Valleeh/taptempo-box/nano-perfboard/mech/out/view_rear.png

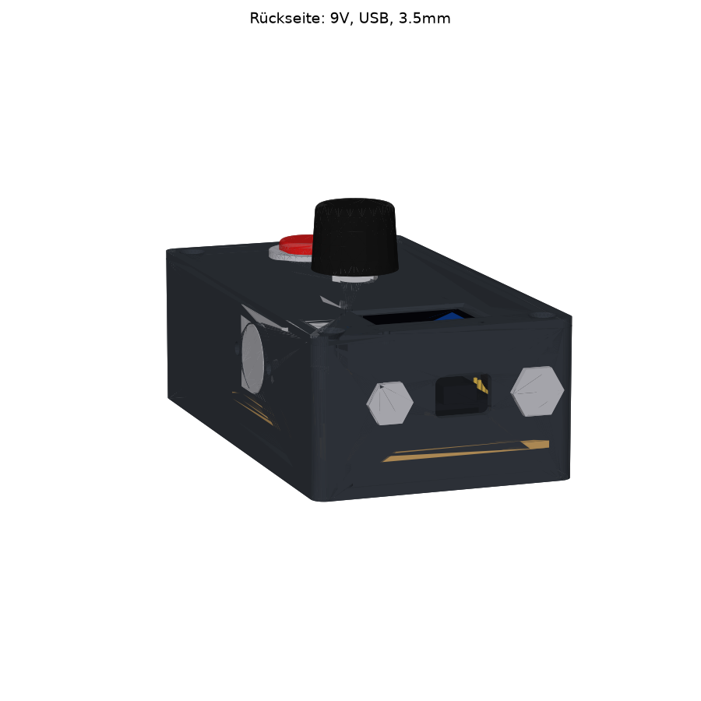
nano-perfboard/mech/out/view_rear.png
