Valleeh/taptempo-box/nano-perfboard/mech/out/view_section.png

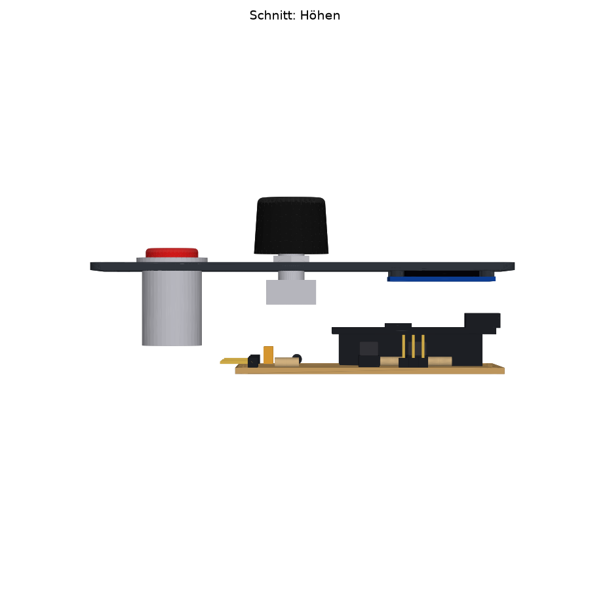
nano-perfboard/mech/out/view_section.png
