Valleeh/taptempo-box/nano-perfboard/mech/out/view_side.png

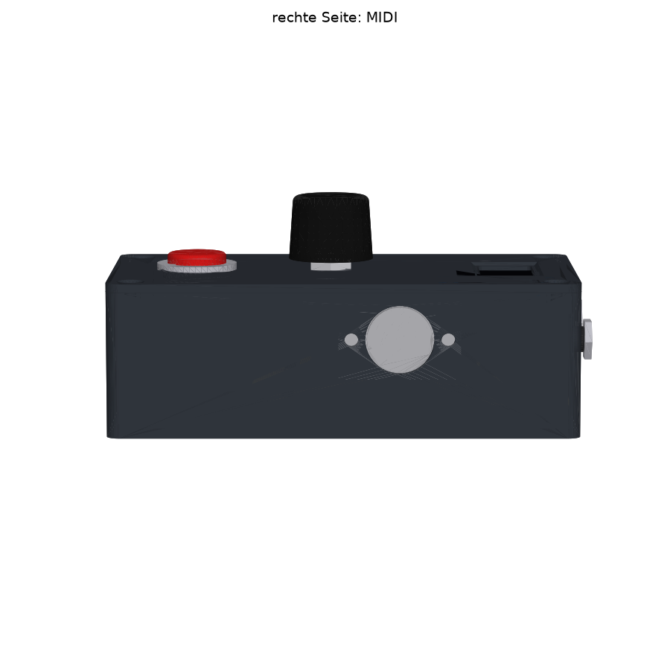
nano-perfboard/mech/out/view_side.png
