Valleeh/taptempo-box/nano-perfboard/mech/out/view_top.png

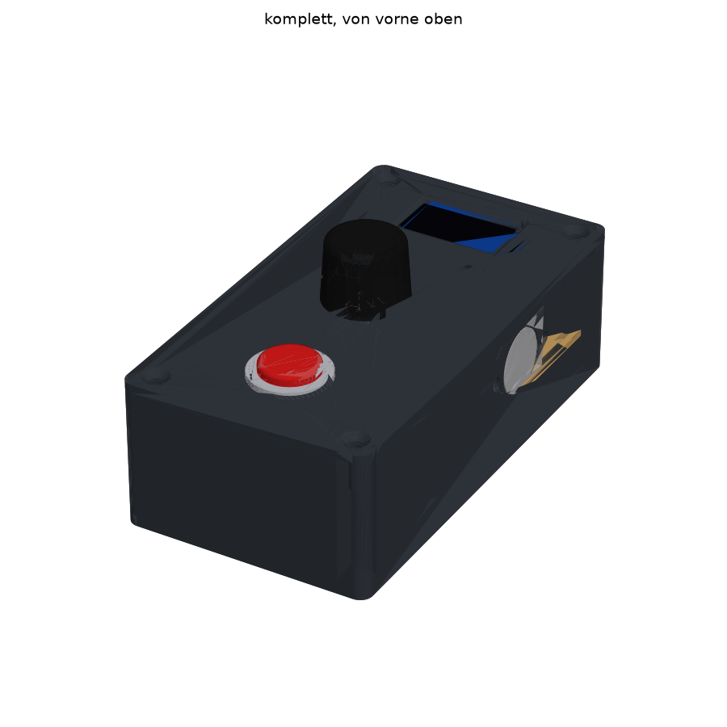
nano-perfboard/mech/out/view_top.png
