Valleeh/taptempo-box/smd-pcb/fab/vorschau_oben.png

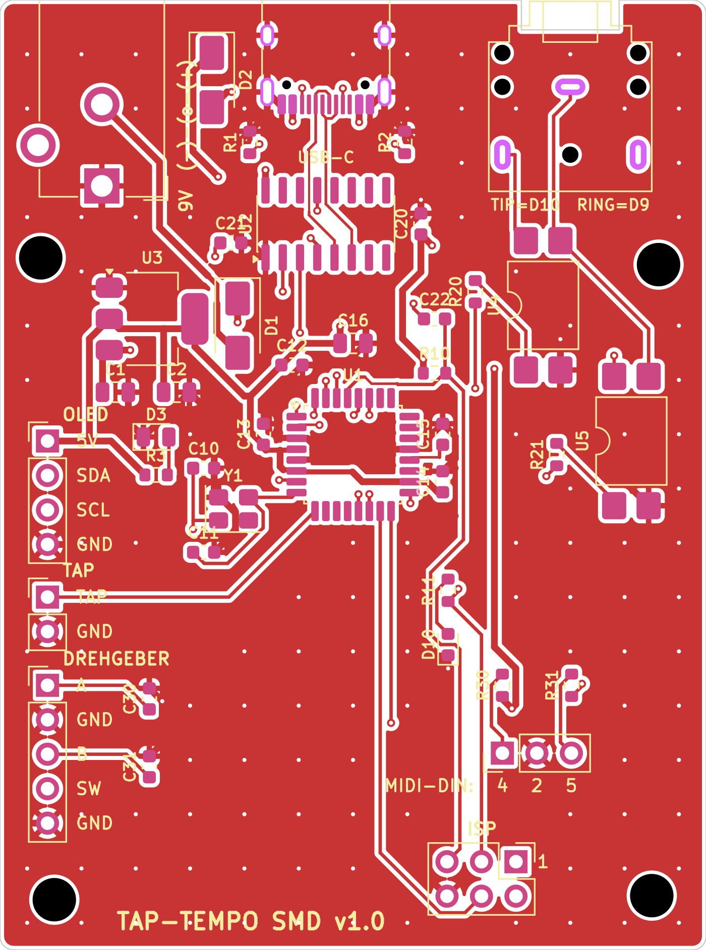
smd-pcb/fab/vorschau_oben.png
