Valleeh/taptempo-box/smd-pcb/fab/vorschau_unten.png

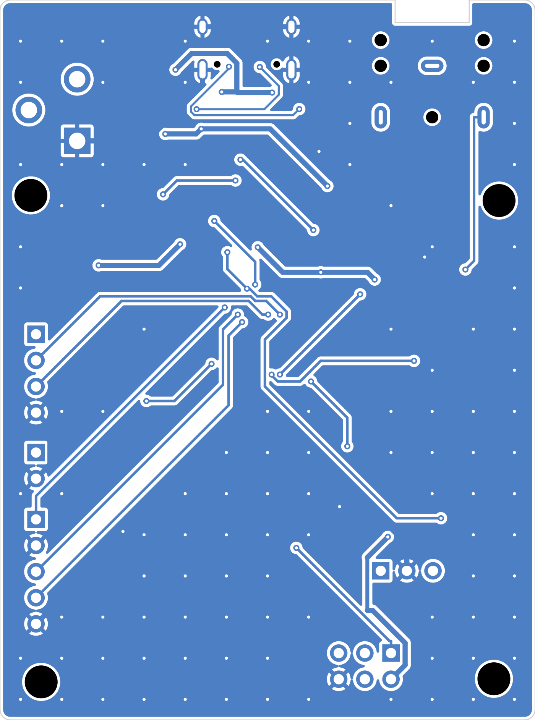
smd-pcb/fab/vorschau_unten.png
