Valleeh/taptempo-box/smd-pcb/mech/out/view_rear.png

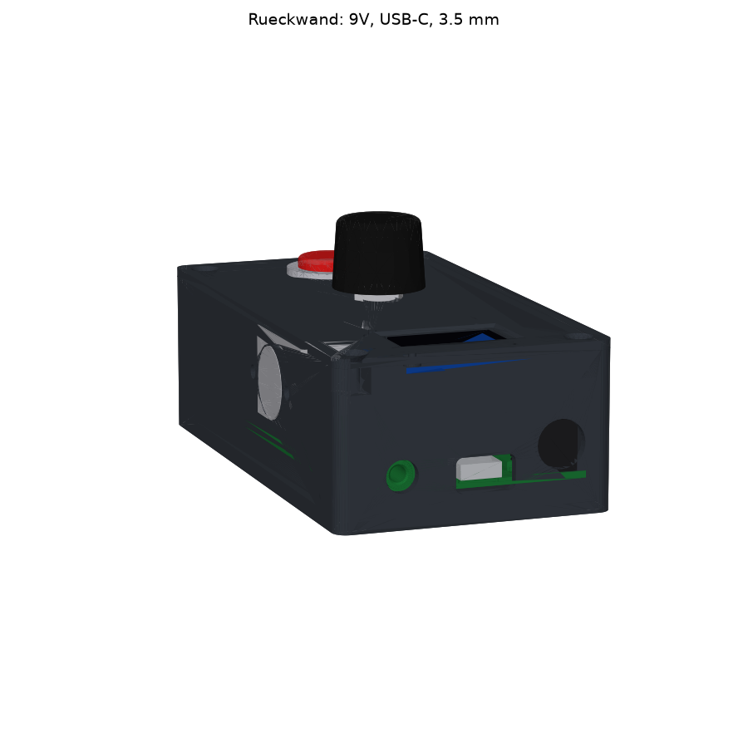
smd-pcb/mech/out/view_rear.png
