Valleeh/taptempo-box/smd-pcb/mech/out/view_section.png

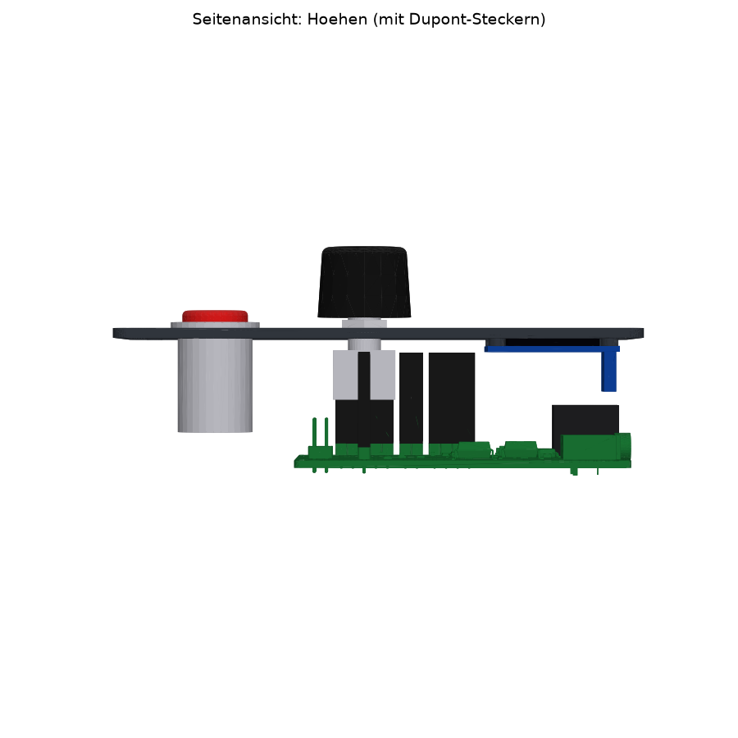
smd-pcb/mech/out/view_section.png
