Valleeh/taptempo-box/smd-pcb/fab/bom_jlcpcb.csv

Comment | Designator | Footprint | LCSC Part #
12pF | C10,C11 | C_0603_1608Metric | C38523
100nF | C12,C13,C14,C15,C20,C21,C22,C30,C31 | C_0603_1608Metric | C14663
10uF | C1,C16 | C_0805_2012Metric | C15850
22uF | C2 | C_0805_2012Metric | C45783
LED_R | D10 | LED_0603_1608Metric | C2286
SS14 | D1,D2 | D_SMA | C2480
LED_G | D3 | LED_0805_2012Metric | C2297
USB-C | J1 | USB_C_Receptacle_HRO_TYPE-C-31-M-12 | C165948
5.1k | R1,R2 | R_0603_1608Metric | C23186
10k | R10 | R_0603_1608Metric | C25804
1k | R3,R11 | R_0603_1608Metric | C21190
220 | R20,R21,R30,R31 | R_0603_1608Metric | C22962
ATmega328P-AU | U1 | TQFP-32_7x7mm_P0.8mm | C14877
CH340C | U2 | SOIC-16_3.9x9.9mm_P1.27mm | C84681
AMS1117-5.0 | U3 | SOT-223-3_TabPin2 | C6187
PC817C | U4,U5 | SMDIP-4_W9.53mm | C3025164
16MHz | Y1 | Crystal_SMD_3225-4Pin_3.2x2.5mm | C13738
