Valleeh/taptempo-box/smd-pcb/fab/tht_selbst_loeten.csv

Bauteil | Designator | Footprint | LCSC Part # | Menge pro Platine
9V DC (PJ-102AH), Minus innen | J2 | BarrelJack_CUI_PJ-102AH_Horizontal | C3096093 | 1
3.5mm TRS (SJ1-3523N) | J3 | Jack_3.5mm_CUI_SJ1-3523N_Horizontal | C20182914 | 1
MIDI DIN (4, 2=GND, 5) | J7 | PinHeader_1x03_P2.54mm_Vertical | C2937625 | 1
OLED (5V SDA SCL GND) | J4 | PinHeader_1x04_P2.54mm_Vertical | C2691448 | 1
Drehgeber (A GND B SW GND) | J5 | PinHeader_1x05_P2.54mm_Vertical | C492404 | 1
TAP (TAP GND) | J6 | PinHeader_1x02_P2.54mm_Vertical | C492401 | 1
ISP (Bootloader) | J8 | PinHeader_2x03_P2.54mm_Vertical | C65114 | 1
