Valleeh/taptempo-box/nano-perfboard/mech/out/assembly.step

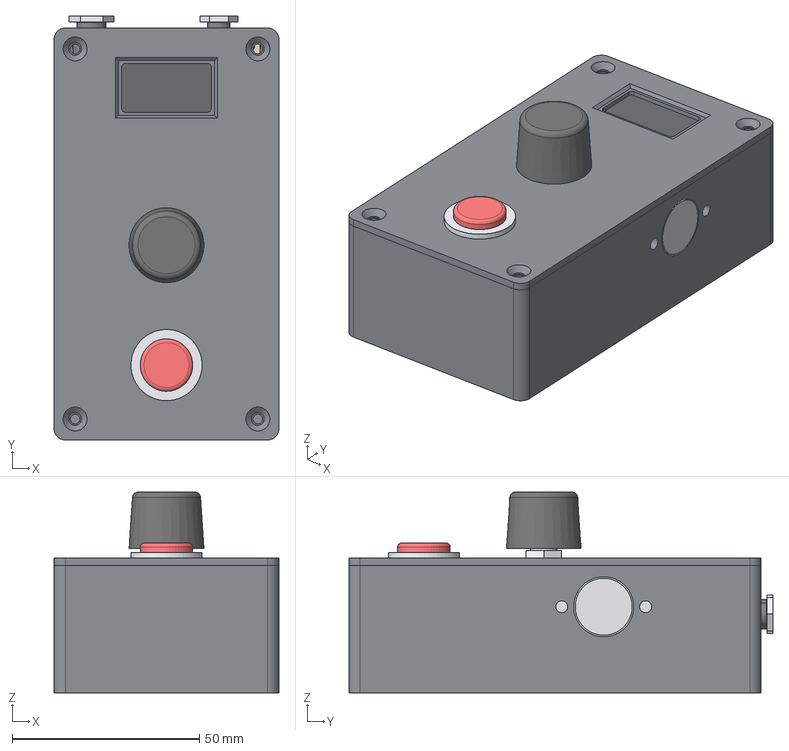
[picture p12: CAD file, 2026-10-27]
nano-perfboard/mech/out/assembly.step
60.0 x 113.2 x 53.6 mm
tray
lid
perfboard
sockets
nano
resistors
ics
headers
pins
diode
caps
encoder
encoder_nut
knob
tap_body
tap_cap
oled_pcb
oled_glass
midi_din
dc_jack
dc_nut
trs_jack
trs_nut
