Valleeh/taptempo-box/smd-pcb/mech/out/assembly.step

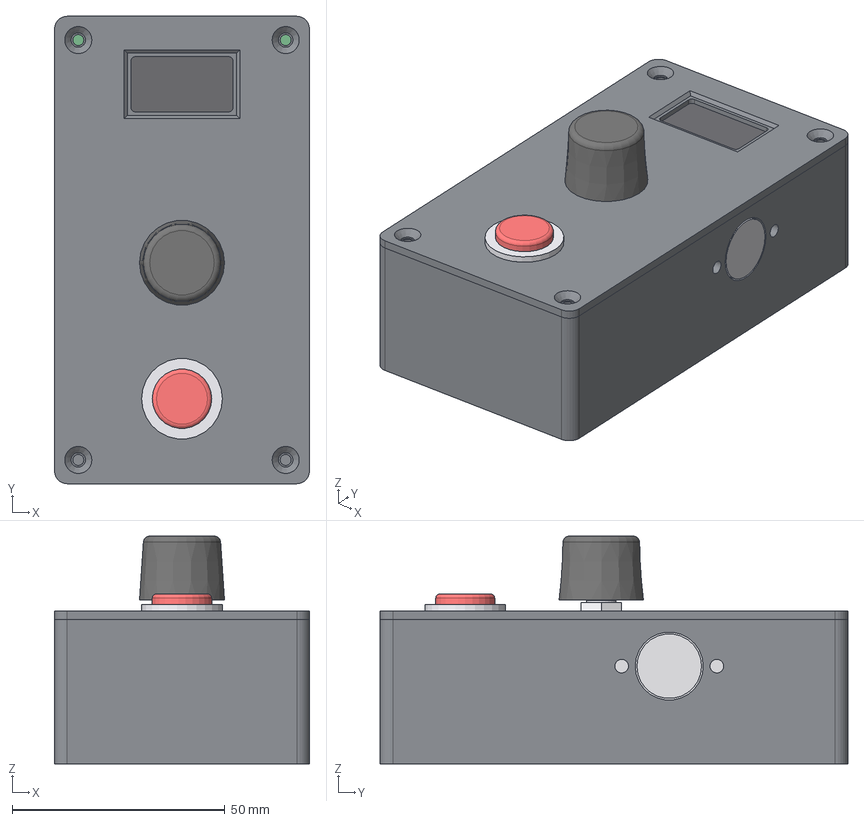
[picture p13: CAD file, 2026-10-27]
smd-pcb/mech/out/assembly.step
60.0 x 110.0 x 53.6 mm
tray
lid
pcb
usb_c
dc_jack
dupont
encoder
encoder_nut
knob
tap_body
tap_cap
oled_pcb
oled_glass
midi_din
