Valleeh/taptempo-box/nano-perfboard/mech/out/tray.step

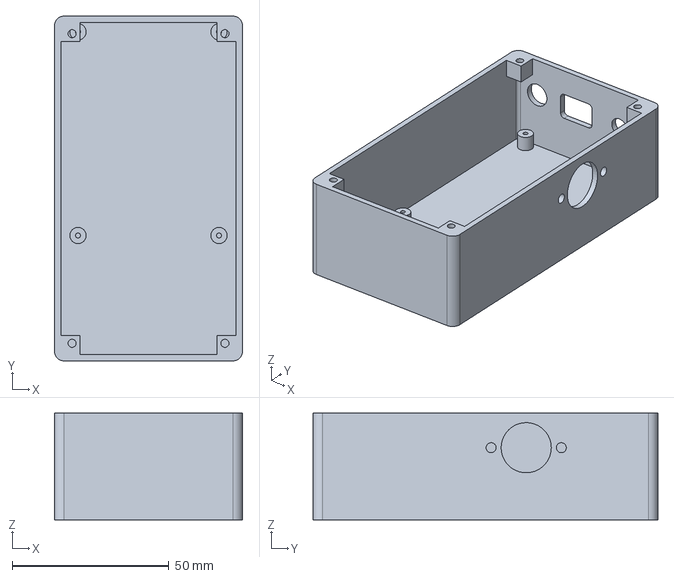
[picture p14: CAD file, 2026-10-27]
nano-perfboard/mech/out/tray.step
60.0 x 110.0 x 34.0 mm
