Valleeh/taptempo-box/nano-perfboard/mech/pcb.step

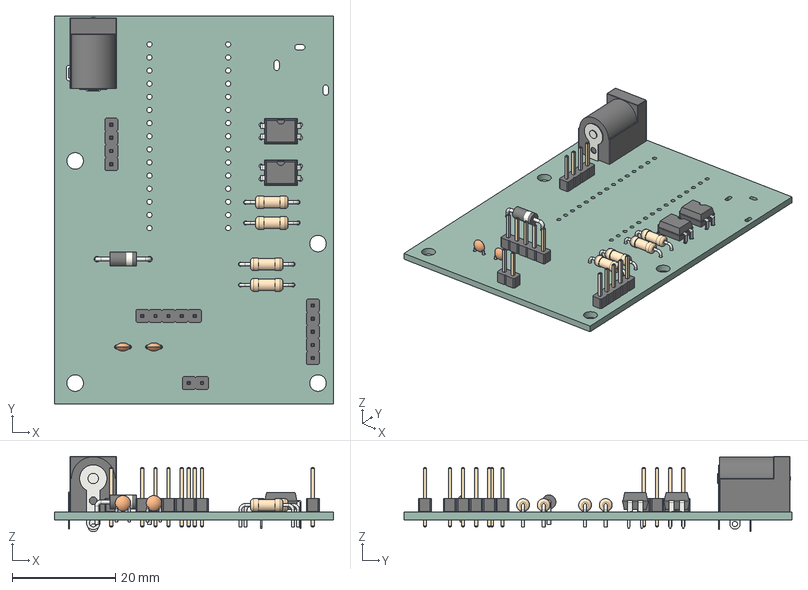
[picture p15: CAD file, 2026-10-27]
nano-perfboard/mech/pcb.step
54.0 x 75.0 x 14.6 mm
DIP-4_W7.62mm x 2
C_Disc_D30mm_W16mm_P250mm x 2
BarrelJack_Horizontal
PinHeader_1x02_P254mm_Vertical
PinHeader_1x05_P254mm_Vertical x 2
R_Axial_DIN0207_L63mm_D25mm_P1016mm_Horizontal x 4
D_DO-41_SOD81_P10.16mm_Horizontal
PinHeader_1x04_P254mm_Vertical
taptempo_PCB
