Valleeh/taptempo-box/nano-perfboard/mech/out/lid.step

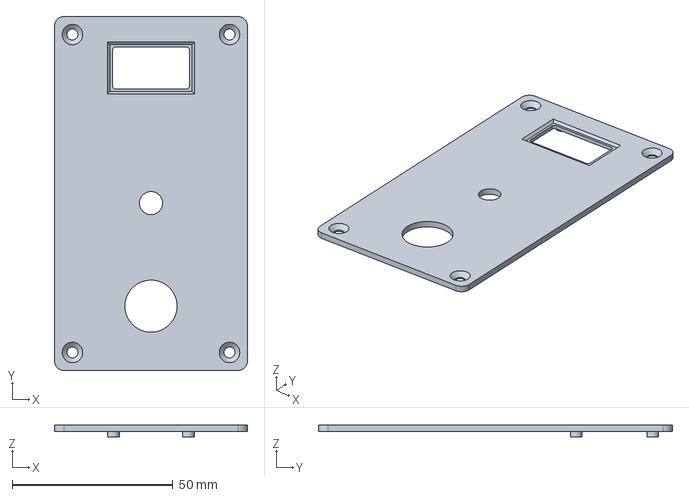
[picture p16: CAD file, 2026-10-27]
nano-perfboard/mech/out/lid.step
60.0 x 110.0 x 3.60 mm
