Valleeh/taptempo-box/smd-pcb/mech/out/pcb.step

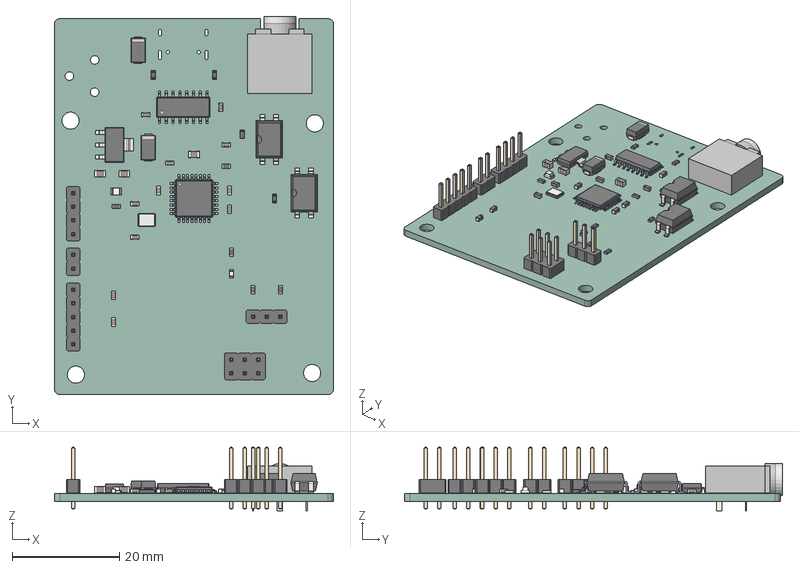
[picture p17: CAD file, 2026-10-27]
smd-pcb/mech/out/pcb.step
52.0 x 70.4 x 11.8 mm
R_0603_1608Metric x 9
C_0603_1608Metric x 11
SMDIP_4_W953mm x 2
LED_0603_1608Metric
Crystal_SMD_3225-4Pin_3.2x2.5mm
D_SMA x 2
C_0805_2012Metric x 3
TQFP-32_7x7mm_P0.8mm
SOIC-16_3.9x9.9mm_P1.27mm
LED_0805_2012Metric
PinHeader_1x02_P254mm_Vertical
PinHeader_1x05_P254mm_Vertical
PinHeader_1x03_P254mm_Vertical
SOT-223
PinHeader_1x04_P254mm_Vertical
Jack_3.5mm_CUI_SJ1-3523N_Horizontal
PinHeader_2x03_P254mm_Vertical
taptempo-smd_PCB
