Valleeh/taptempo-box/(list of files, cad)

Other CAD files:
smd-pcb/mech/out/tray.step
smd-pcb/mech/out/lid.step
nano-perfboard/mech/out/lid.stl
nano-perfboard/mech/out/tray.stl
smd-pcb/mech/out/lid.stl
smd-pcb/mech/out/tray.stl
