Valleeh/taptempo-box/nano-perfboard/share/taptempo-bauanleitung.html

# Tap-Tempo-Box löten

Schritt für Schritt auf einer Lochrasterplatine, ohne Vorkenntnisse. Alles, was man falsch herum einsetzen kann, ist markiert. Hake beim Löten ab, was erledigt ist; die Haken bleiben in diesem Browser gespeichert.

Zeit: ca. 4–6 StundenPlatine 5 × 7 cm, 18 × 24 Löcher26 Brücken, 10 Drähte0 erledigt

## Einkaufsliste

Anzahl | Teil | Hinweis
1 | Lochrasterplatine 5 × 7 cm (Lötpunkte, 2,54 mm) | doppelseitig verzinnt ist leichter zu löten
1 | Arduino Nano (Klon reicht) | mit Mini-USB oder USB-C, beides passt
2 | Buchsenleiste 15-polig, 2,54 mm | Sockel für den Nano
2 | IC-Sockel 4-polig (DIP-4) | oder einen 8-poligen durchsägen
2 | Optokoppler PC817 | DIP-Gehäuse
4 | Widerstand 220 Ω, ¼ W | Farbringe Rot-Rot-Braun
2 | Kondensator 100 nF (Keramik, „104“) | Rastermaß 2,5 mm
1 | Schottky-Diode 1N5817 | Verpolschutz
1 | Stiftleiste gerade, 1 × 40 | für Display und Klinke
1 | Stiftleiste gewinkelt 90°, 1 × 40 | für die vordere Reihe
1 Pack | Dupont-Kabel Buchse–Buchse, 20 cm | werden halbiert, kein Crimpen nötig
1 | Drehgeber EC11 mit Drucktaster + Knopf | 5 Beine: 3 vorne, 2 hinten
1 | Drucktaster 16 mm, nicht rastend | max. 22 mm tief
1 | OLED 0,96″ I²C (SSD1306), 4 Pins | 27 × 28 mm
1 | MIDI-Einbaubuchse DIN 5-polig 180° | mit 2 Schraublöchern
1 | Klinken-Einbaubuchse 3,5 mm Stereo | Gewinde M6
1 | Hohlstecker-Einbaubuchse 5,5/2,1 mm | passend zu deinem Netzteil
je 4 | Schrauben M2 × 6 und M3 × 8 (Senkkopf) | Platine bzw. Deckel
| Schaltdraht (isoliert) in mehreren Farben, verzinnter Draht 0,5 mm, Schrumpfschlauch

### Werkzeug

Lötkolben mit Temperaturregelung, Lötzinn 0,8 mm mit Flussmittel, Seitenschneider, Abisolierzange, Multimeter mit Piepser, „dritte Hand“ oder Knete zum Festhalten, Filzstift.

## Fünf Regeln fürs Löten

1. Lötkolben auf ca. 330 °C. Die Spitze immer leicht verzinnt halten, am nassen Schwamm oder Messingwolle abwischen.
2. Erst Pad und Bein 1–2 Sekunden gleichzeitig erhitzen, dann das Zinn an die Stelle halten (nicht an die Spitze).
3. Eine gute Lötstelle glänzt und sieht aus wie ein kleiner Vulkan. Eine Kugel oder graue Krümel: noch mal erhitzen.
4. Nach jedem Bauteil die Beine kurz abschneiden. Nicht länger als 3–4 Sekunden auf einer Stelle bleiben.
5. Nie löten, solange USB oder Netzteil angeschlossen ist. Gut lüften.

## Der Lochplan

Die Löcher sind wie auf einem Steckbrett benannt: Spalten A–R von links nach rechts, Reihen 1–24 von hinten nach vorne. K12 heißt Spalte K, Reihe 12.

Wichtig: Von unten ist alles seitenverkehrt. Schreib mit Filzstift auf beide Seiten der Platine „A1“ an die Ecke links hinten (von oben gesehen) und „R24“ an die gegenüberliegende Ecke. Dann kannst du dich nicht verzählen.

Bestückungsseite, von oben. Hier stecken die Bauteile.

Lötseite, von unten (gespiegelt). Grau: blanke Brücken. Farbig: isolierte Drähte mit Nummer.

## 1Flache Bauteile

Immer vom flachsten zum höchsten Bauteil löten, dann liegt die Platine beim Umdrehen plan auf. Bein durchstecken, auf der Unterseite leicht auseinanderbiegen, löten, abschneiden.

- R1–R4 (220 Ω, Rot-Rot-Braun). Richtung egal. R1: P19–P23 · R2: R19–R23 · R3: L3–L7 · R4: L8–L12
- D1 (1N5817): A20–E20. Der Ring zeigt nach rechts zu E20, zum Nano.
- C1: F23–G23 und C2: I23–J23. Richtung egal.
- IC-Sockel U2 (M7, M8, P7, P8) und U3 (M12, M13, P12, P13). Die Kerbe des Sockels zeigt nach hinten (zu Reihe 1), dann weißt du später, wo Pin 1 hinkommt.

## 2Sockel und Stiftleisten

- Nano-Sockel: je eine 15-polige Buchsenleiste in E1–E15 und K1–K15. Trick: Den Nano zum Löten einstecken, dann sitzen beide Leisten garantiert im richtigen Abstand. Erst je ein Bein an den Enden löten, Sitz prüfen, dann den Rest. Danach den Nano wieder herausziehen.
- Gerade Stiftleisten (kurze Seite in die Platine): 4 Pins in B7–B10 (Display) und 3 Pins in R7–R9 (Klinke).
- Gewinkelte Stiftleisten in Reihe 24, Stifte zeigen nach vorne über den Platinenrand hinaus: A24–B24 (9 V), G24–K24 (Drehgeber), M24–N24 (TAP), P24–R24 (MIDI).

## 3Brücken auf der Lötseite

Grau im Lochplan. Bei direkt benachbarten Löchern einfach ein abgeschnittenes Bein oder einen Tropfen Zinn als Brücke nehmen. Bei längeren Strecken verzinnten Draht auf die Lötpunkte legen und an jedem genannten Punkt verlöten. Blanker Draht darf keine anderen Lötpunkte berühren.

| Nr. | Von → nach | Wofür | Wie
| B1 | K3 → L3 | D10 → Widerstand R3 | Bein umbiegen oder Lötbrücke
| B2 | L7 → M7 | R3 → Optokoppler U2 | Bein umbiegen oder Lötbrücke
| B3 | L12 → M12 | R4 → Optokoppler U3 | Bein umbiegen oder Lötbrücke
| B4 | P7 → R7 | U2 → Klinke Tip | blanker Draht
| B5 | P8 → R8 | Optokoppler → Klinke Sleeve | blanker Draht
| B6 | Q8 → Q13 | Optokoppler → Klinke Sleeve | blanker Draht
| B7 | Q13 → P13 | Optokoppler → Klinke Sleeve | Bein umbiegen oder Lötbrücke
| B8 | E8 → B8 | A4 → Display SDA | blanker Draht
| B9 | E9 → B9 | A5 → Display SCL | blanker Draht
| B10 | B10 → B22 | Masse (GND) | blanker Draht
| B11 | E14 → D14 → D22 | Masse (GND) | blanker Draht
| B12 | M13 → L13 → L22 | Masse (GND) | blanker Draht
| B13 | B22 → Q22 | Masse (GND) | blanker Draht
| B14 | B24 → B22 | Masse (GND) | blanker Draht
| B15 | H24 → H22 | Masse (GND) | blanker Draht
| B16 | K24 → K22 | Masse (GND) | blanker Draht
| B17 | N24 → N22 | Masse (GND) | blanker Draht
| B18 | Q24 → Q22 | Masse (GND) | blanker Draht
| B19 | F23 → F22 | Masse (GND) | Bein umbiegen oder Lötbrücke
| B20 | J23 → J22 | Masse (GND) | Bein umbiegen oder Lötbrücke
| B21 | G23 → G24 | C1 an Drehgeber A | Bein umbiegen oder Lötbrücke
| B22 | I23 → I24 | C2 an Drehgeber B | Bein umbiegen oder Lötbrücke
| B23 | P23 → P24 | R1 → MIDI Pin 4 | Bein umbiegen oder Lötbrücke
| B24 | R23 → R24 | R2 → MIDI Pin 5 | Bein umbiegen oder Lötbrücke
| B25 | A24 → A20 | 9 V → Diode | blanker Draht
| B26 | E20 → E15 | Diode → Nano VIN | blanker Draht

## 4Isolierte Drähte

Farbig im Lochplan, mit Nummer. Draht etwas länger abschneiden als nötig, Enden 3 mm abisolieren, verzinnen und direkt an den Lötpunkt des Bauteilbeins anlöten. Diese Drähte dürfen sich kreuzen.

| Nr. | Von → nach | Wofür | Farbe
| 1 | K4 → L8 | D9 → Widerstand R4 | gelb
| 2 | M8 → M13 | Masse (GND) | schwarz
| 3 | P12 → R9 | U3 → Klinke Ring | grün
| 4 | E12 → B7 | 5 V vom Nano | rot
| 5 | E12 → P19 | 5 V vom Nano | rot
| 6 | K15 → R19 | TX → Widerstand R2 | orange
| 7 | K8 → M24 | D5 → TAP-Leiste | weiß
| 8 | K9 → J24 | D4 → Drehgeber-Taster | violett
| 9 | K10 → G24 | C1 an Drehgeber A | blau
| 10 | K11 → I24 | C2 an Drehgeber B | blau

## 5Durchmessen, bevor Strom drauf kommt

Multimeter auf Durchgang (Piepser). Nano und Optokoppler sind noch nicht eingesteckt.

- Kein Piep zwischen E12 (5V) und E14 (GND). Piept es: Kurzschluss suchen, nicht weitermachen.
- Kein Piep zwischen A24 (+9 V) und B24 (GND).
- Piep zwischen E14 und jedem dieser Punkte: B10, B24, H24, K24, N24, Q24, M8, M13.
- Piep zwischen K8 und M24 (TAP), K9 und J24, K10 und G24, K11 und I24.
- Piep zwischen E8 und B8 (SDA), E9 und B9 (SCL), E12 und B7, E12 und P19.
- Dioden-Messbereich: Rot an A20, Schwarz an E20 zeigt ca. 0,2–0,3 V. Andersherum: nichts.
- Mit der Lupe: keine Zinnbrücken zwischen benachbarten Lötpunkten, vor allem an den Nano-Leisten.

## 6Kabel für Deckel und Buchsen

Dupont-Kabel in der Mitte durchschneiden. Die Buchse (schwarzes Steckerende) kommt auf die Stiftleiste, das freie Ende wird an das Bauteil gelötet. Über jede Lötstelle Schrumpfschlauch. Kabel lang genug lassen, dass sich der Deckel aufklappen lässt (ca. 15 cm).

Teil | Leiste | Anschluss
TAP-Taster | M24, N24 | beide Beine des Tasters, Richtung egal
Drehgeber | G24–K24 | 3er-Seite: links A → G24, Mitte C → H24, rechts B → I24. 2er-Seite (Taster) → J24 und K24. Dreht er falsch herum, A und B tauschen.
Display | B7–B10 | nach Beschriftung: VCC → 5V (B7), SDA → B8, SCL → B9, GND → B10. Die Reihenfolge am Display ist je nach Hersteller anders; nur die Namen zählen. Am Display die Kabel direkt anlöten, kein Dupont-Stecker (sonst wird es unter dem Deckel zu hoch). Hat das Display schon Stifte, die Kabel daran löten und die Stifte danach kürzen.
MIDI-Buchse | P24, Q24, R24 | Pin 4 → P24, Pin 2 (mittlerer Kontakt) → Q24, Pin 5 → R24. Die Nummern stehen meist klein neben den Lötfahnen. Pins 1 und 3 bleiben frei.
Klinkenbuchse | R7, R8, R9 | Tip → R7, Sleeve → R8, Ring → R9. Welche Fahne was ist: Stecker einstecken und mit dem Piepser suchen.
9-V-Buchse | A24 (+), B24 (−) | siehe Hinweis zum Netzteil

Netzteil: Auf dem Netzteil ist ein kleines Symbol mit Plus und Minus. Effektgeräte-Netzteile (Boss-Standard) haben Minus innen: dann den Mittelstift der Buchse an B24 (−) und den äußeren Kontakt an A24 (+). Bei „Plus innen“ genau umgekehrt. Falsch herum geht nichts kaputt (dafür ist die Diode da), die Box bleibt nur aus.

## 7Einstecken und erster Test

- Optokoppler in die Sockel: Der Punkt auf dem Chip kommt nach links oben, auf M7 bzw. M12.
- Nano in den Sockel: USB-Buchse nach hinten zu Reihe 1. Pin „D12“ steckt in K1, „VIN“ in E15. Die Beschriftung auf dem Nano muss zum Lochplan passen.
- Nur USB anschließen. Arduino IDE installieren, Bibliothek U8g2 installieren (Werkzeuge → Bibliotheken verwalten), Board „Arduino Nano“ wählen. Bei Klonen unter Prozessor „ATmega328P (Old Bootloader)“ probieren, falls das Hochladen scheitert.
- Test-Sketch unten hochladen. Das Display zeigt „Hardware-Test“. TAP und Drehgeber-Taster müssen „an“ anzeigen, Drehen zählt hoch und runter.
- Klinken-Ausgang: Multimeter auf Durchgang zwischen Tip und Sleeve der Klinkenbuchse. Es piept im Sekundentakt abwechselnd mit Ring–Sleeve.
- Dann das 9-V-Netzteil statt USB: Display muss wieder angehen.

### Test-Sketch

// Tap-Tempo-Box: Hardware-Test
// Zeigt auf dem Display und im Seriellen Monitor (115200 Baud), ob Taster und
// Drehgeber funktionieren, und schaltet die beiden Klinken-Ausgänge abwechselnd.
// Benötigt die Bibliothek "U8g2" (Arduino IDE: Werkzeuge > Bibliotheken verwalten).

#include <U8x8lib.h>

U8X8_SSD1306_128X64_NONAME_HW_I2C oled(U8X8_PIN_NONE);

const int PIN_TAP = 5;     // TAP-Taster
const int PIN_SS = 4;      // Drucktaster im Drehgeber (Start/Stop)
const int PIN_A = 3;       // Drehgeber A
const int PIN_B = 2;       // Drehgeber B
const int PIN_TIP = 10;    // Optokoppler U2 -> Klinke Tip
const int PIN_RING = 9;    // Optokoppler U3 -> Klinke Ring

volatile int position = 0;

void onTurn() {
  if (digitalRead(PIN_A) == digitalRead(PIN_B)) position++;
  else position--;
}

void setup() {
  pinMode(PIN_TAP, INPUT_PULLUP);
  pinMode(PIN_SS, INPUT_PULLUP);
  pinMode(PIN_A, INPUT_PULLUP);
  pinMode(PIN_B, INPUT_PULLUP);
  pinMode(PIN_TIP, OUTPUT);
  pinMode(PIN_RING, OUTPUT);
  attachInterrupt(digitalPinToInterrupt(PIN_A), onTurn, CHANGE);

  Serial.begin(115200);
  oled.begin();
  oled.setFont(u8x8_font_chroma48medium8_r);
  oled.drawString(0, 0, "Tap-Tempo-Box");
  oled.drawString(0, 1, "Hardware-Test");
}

void loop() {
  static unsigned long lastToggle = 0;
  static bool tipClosed = false;
  if (millis() - lastToggle > 1000) {            // jede Sekunde umschalten
    lastToggle = millis();
    tipClosed = !tipClosed;
    digitalWrite(PIN_TIP, tipClosed);
    digitalWrite(PIN_RING, !tipClosed);
  }

  bool tap = digitalRead(PIN_TAP) == LOW;        // gedrückt = LOW
  bool ss = digitalRead(PIN_SS) == LOW;
  noInterrupts();
  int pos = position;
  interrupts();

  char line[17];
  snprintf(line, sizeof line, "TAP:%s SS:%s", tap ? "an " : "aus", ss ? "an " : "aus");
  oled.drawString(0, 3, line);
  snprintf(line, sizeof line, "Dreh: %-8d", pos);
  oled.drawString(0, 4, line);
  snprintf(line, sizeof line, "Tip:%s Ring:%s", tipClosed ? "zu " : "auf", tipClosed ? "auf" : "zu ");
  oled.drawString(0, 6, line);

  Serial.print("TAP=");  Serial.print(tap);
  Serial.print("  StartStop=");  Serial.print(ss);
  Serial.print("  Drehgeber=");  Serial.println(pos);
  delay(50);
}

## 8Einbau

- Buchsen in die Rückwand (9 V links, 3,5 mm rechts) und die MIDI-Buchse in die rechte Seitenwand schrauben. Passt eine Buchse nicht durchs Loch, vorsichtig aufbohren.
- Platine mit 4 Schrauben M2 auf die Abstandshalter, USB-Buchse zeigt zur Rückwand in die Öffnung.
- Taster, Drehgeber (mit Mutter) und Display (4 kleine Schrauben M2) am Deckel befestigen, Kabel aufstecken.
- Deckel mit 4 Schrauben M3 zuschrauben.

## Wenn etwas nicht geht

- Display bleibt dunkel: SDA und SCL vertauscht oder VCC/GND falsch. Bei manchen Displays steht die Adresse 0x3D statt 0x3C.
- Nano wird heiß: sofort abstecken, Kurzschluss zwischen 5V und GND suchen (Schritt 5).
- Taster reagiert nicht: Durchgang von der Stiftleiste zum Nano-Pin messen (Drahttabelle).
- MIDI kommt nicht an: Pin 4 und Pin 5 an der Buchse tauschen. Dabei geht nichts kaputt.
- Klinke schaltet nicht: Optokoppler falsch herum im Sockel (Punkt nach links oben).
