Valleeh/taptempo-box/nano-perfboard/perfboard/solder_side.png

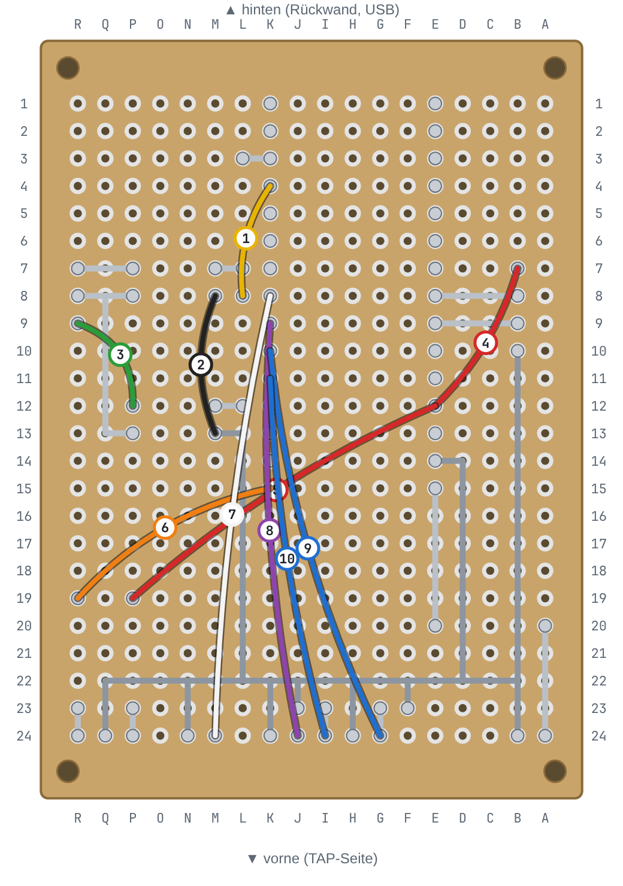
nano-perfboard/perfboard/solder_side.png
