Valleeh/taptempo-box/nano-perfboard/kicad/schaltplan.pdf

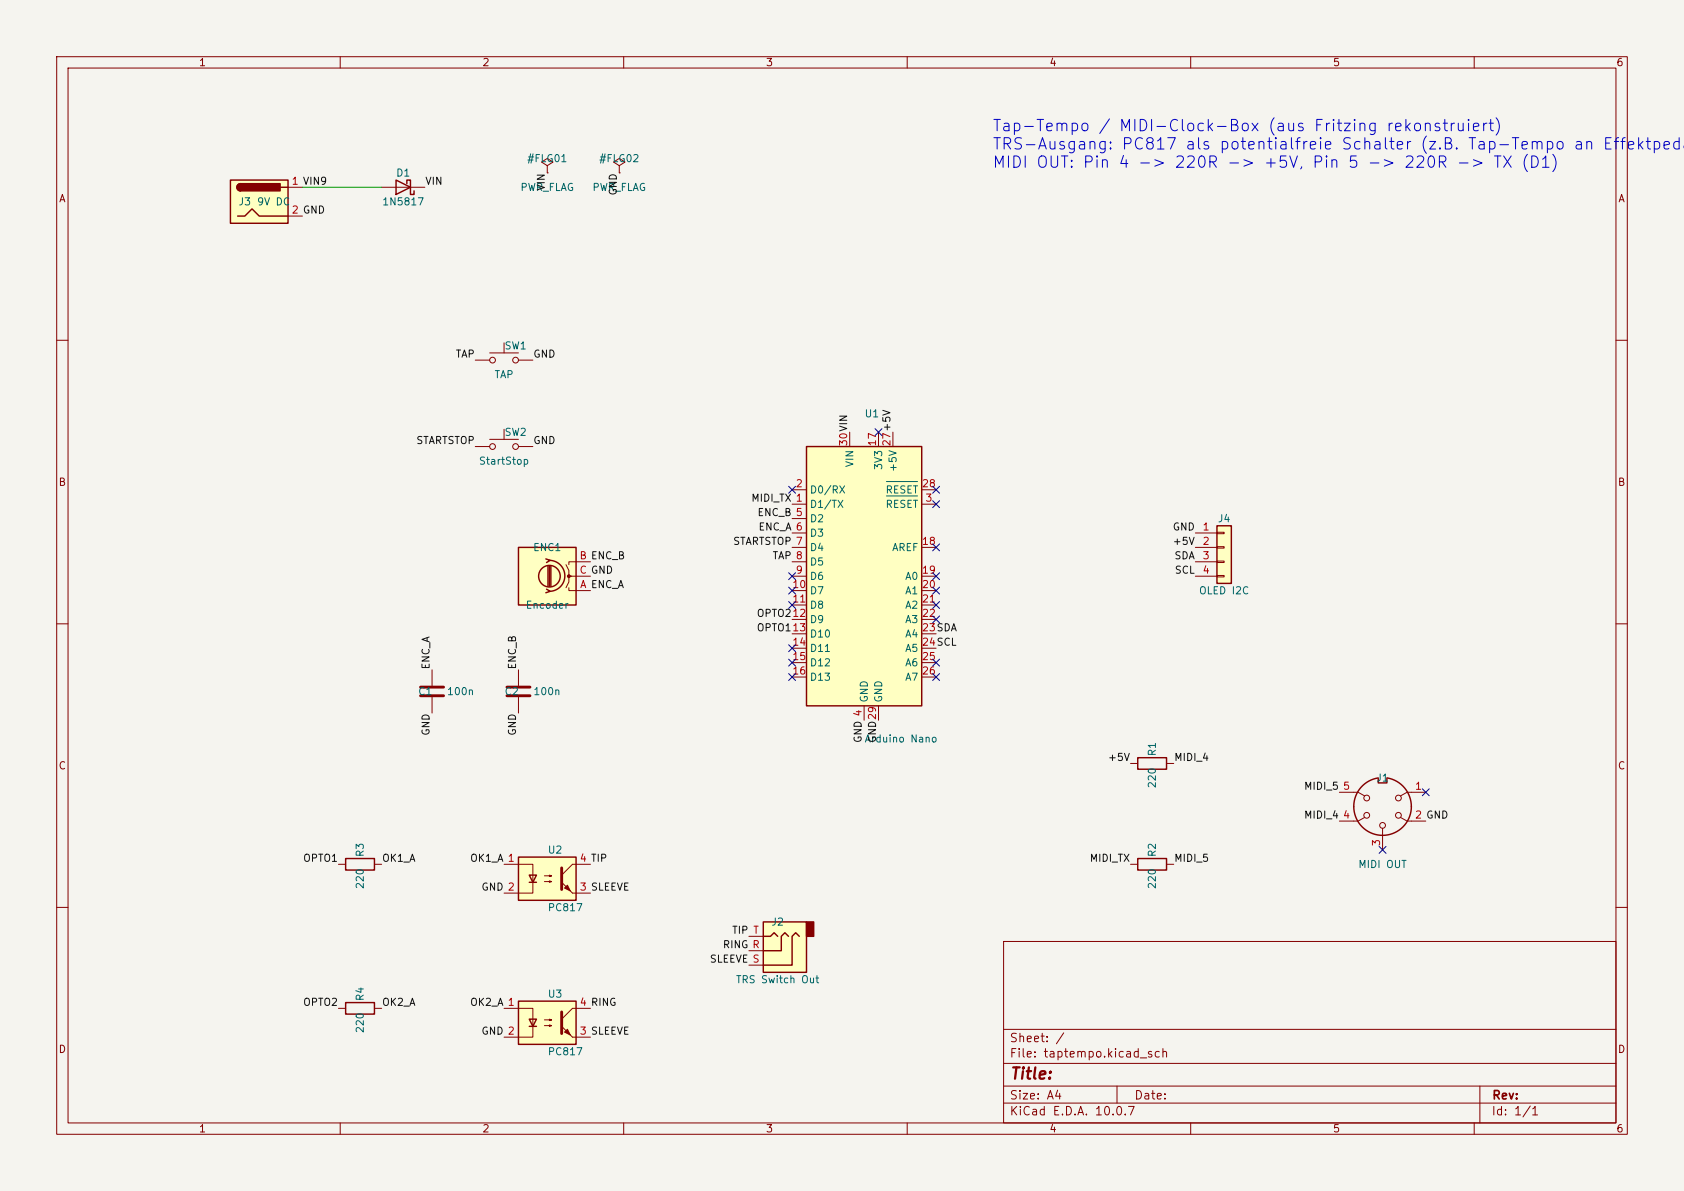
[picture p19: page 1]

TRS-Ausgang: PC817 als potentialfreie Schalter (z.B. Tap-Tempo an Effektpedal)
MIDI OUT: Pin 4 -> 220R -> +5V, Pin 5 -> 220R -> TX (D1)

Size: A4 | Rev:
KiCad E.D.A. 10.0.7 | Id: 1/1
