Valleeh/taptempo-box/smd-pcb/kicad/taptempo-smd-schaltplan.pdf

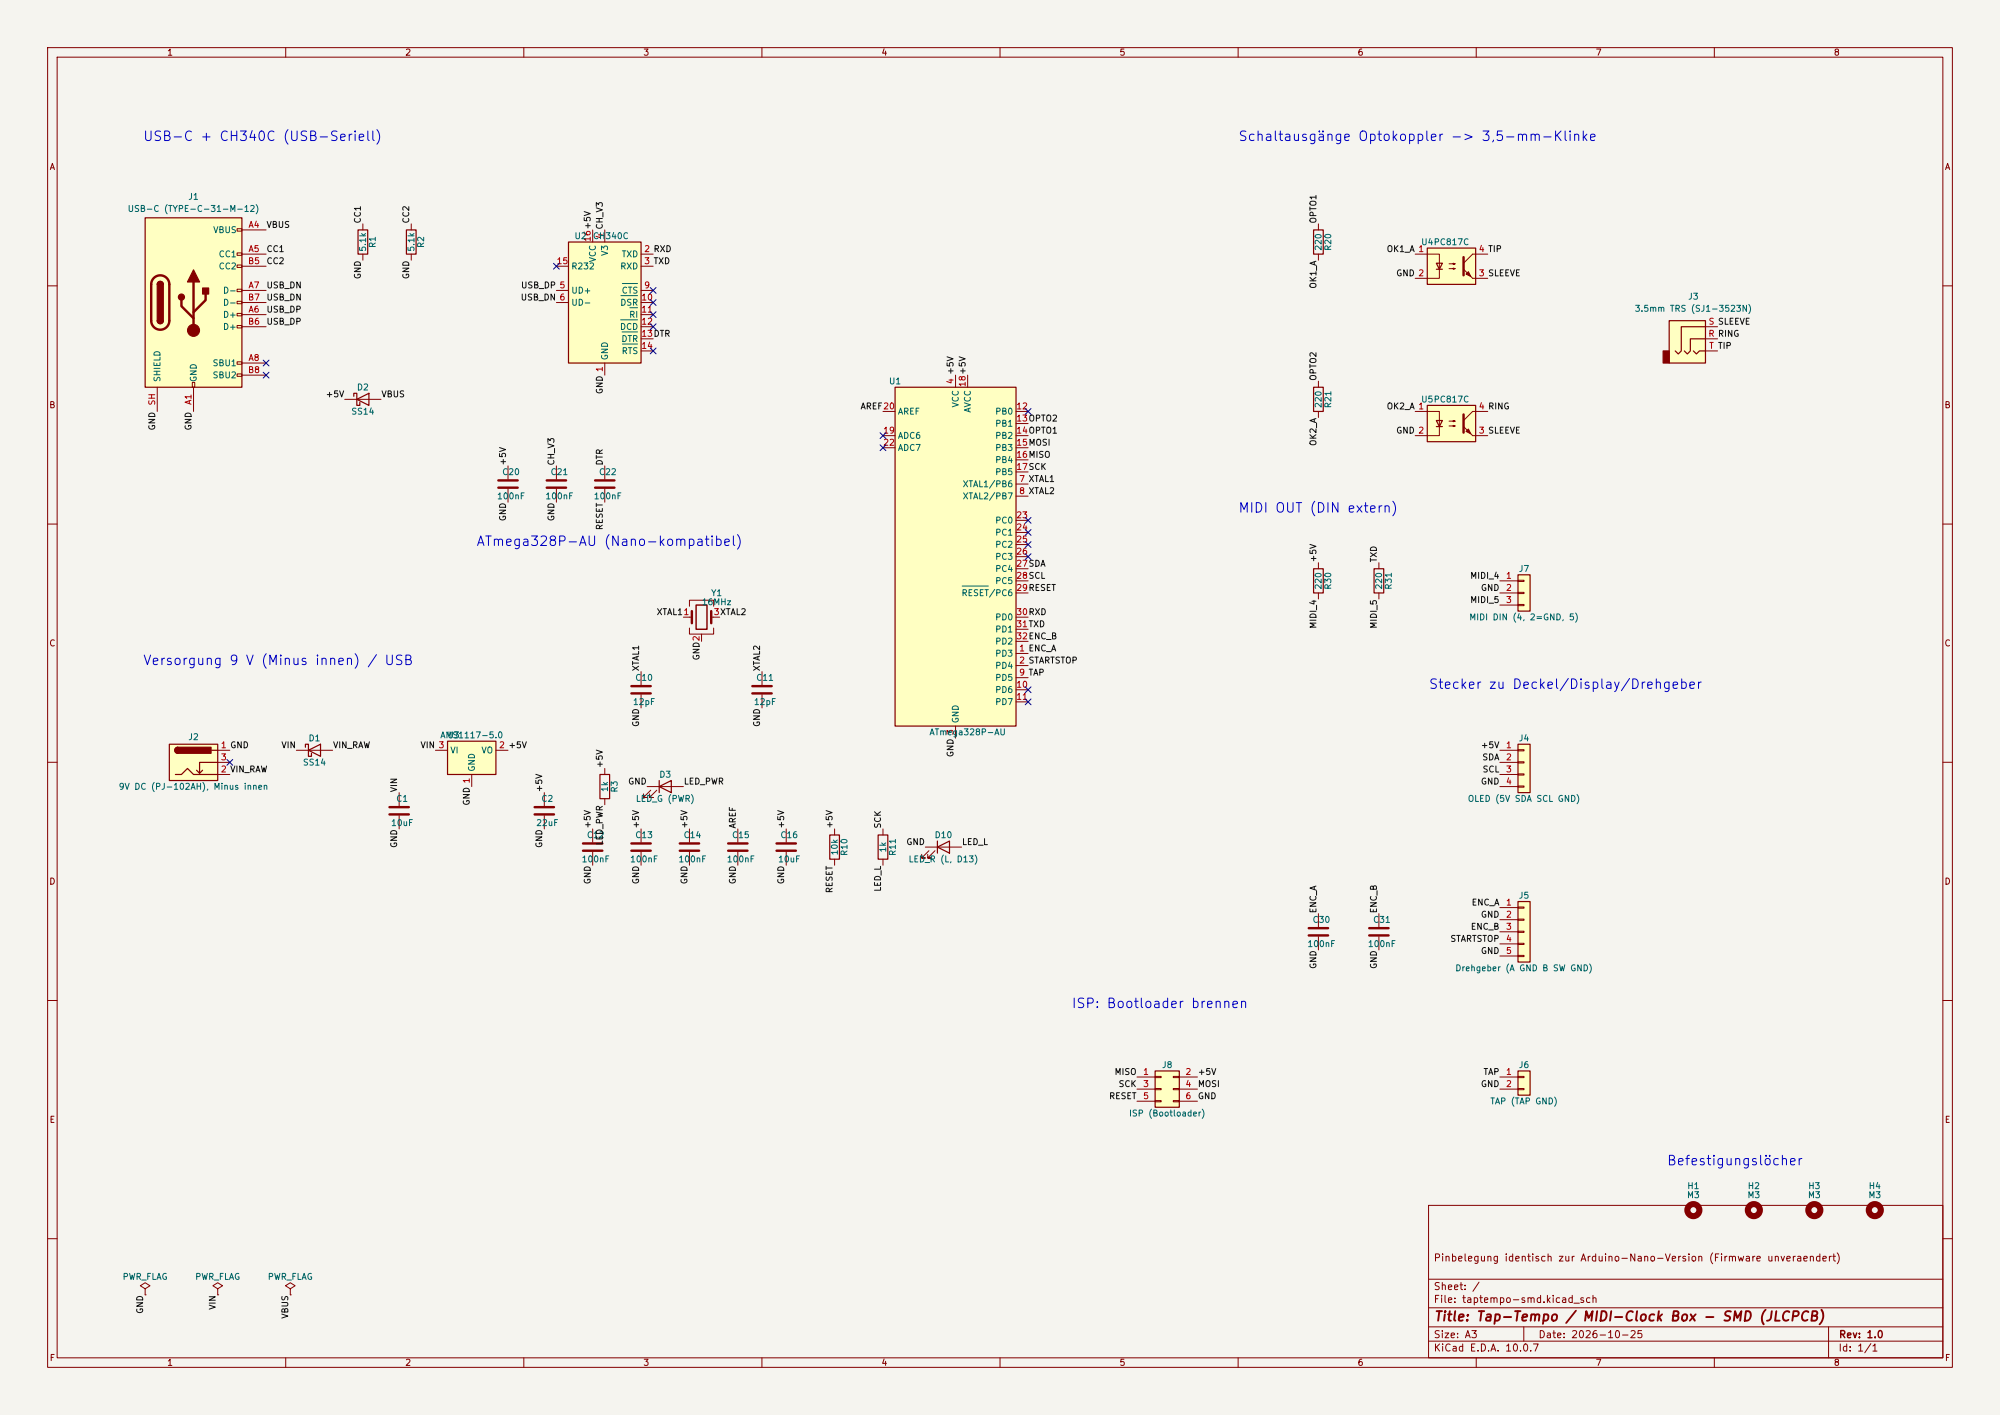
[picture p20: page 1]

4 UD+ 5 UD- 6 CTS 9 DSR 10 RI 11 DCD 12 DTR 13 RTS 14 R232 15 VCC U2 16CH340C 220 R20 R

J4 OLED (5V SDA SCL GND) C21

MIDI OUT (DIN extern)

Versorgung 9 V (Minus innen) / USB

Stecker zu Deckel/Display/Drehgeber

Pinbelegung identisch zur Arduino-Nano-Version (Firmware unveraendert)

Sheet: /
File: taptempo-smd.kicad_sch
Title: Tap-Tempo / MIDI-Clock Box - SMD (JLCPCB)

Size: A3 | Rev: 1.0 | F Date: 2026-10-25
KiCad E.D.A. 10.0.7 | Id: 1/1
