Valleeh/taptempo-box/smd-pcb/kicad/taptempo-smd.kicad_pcb

## KiCad design smd-pcb/kicad/taptempo-smd.kicad_pcb (2026-10-27)

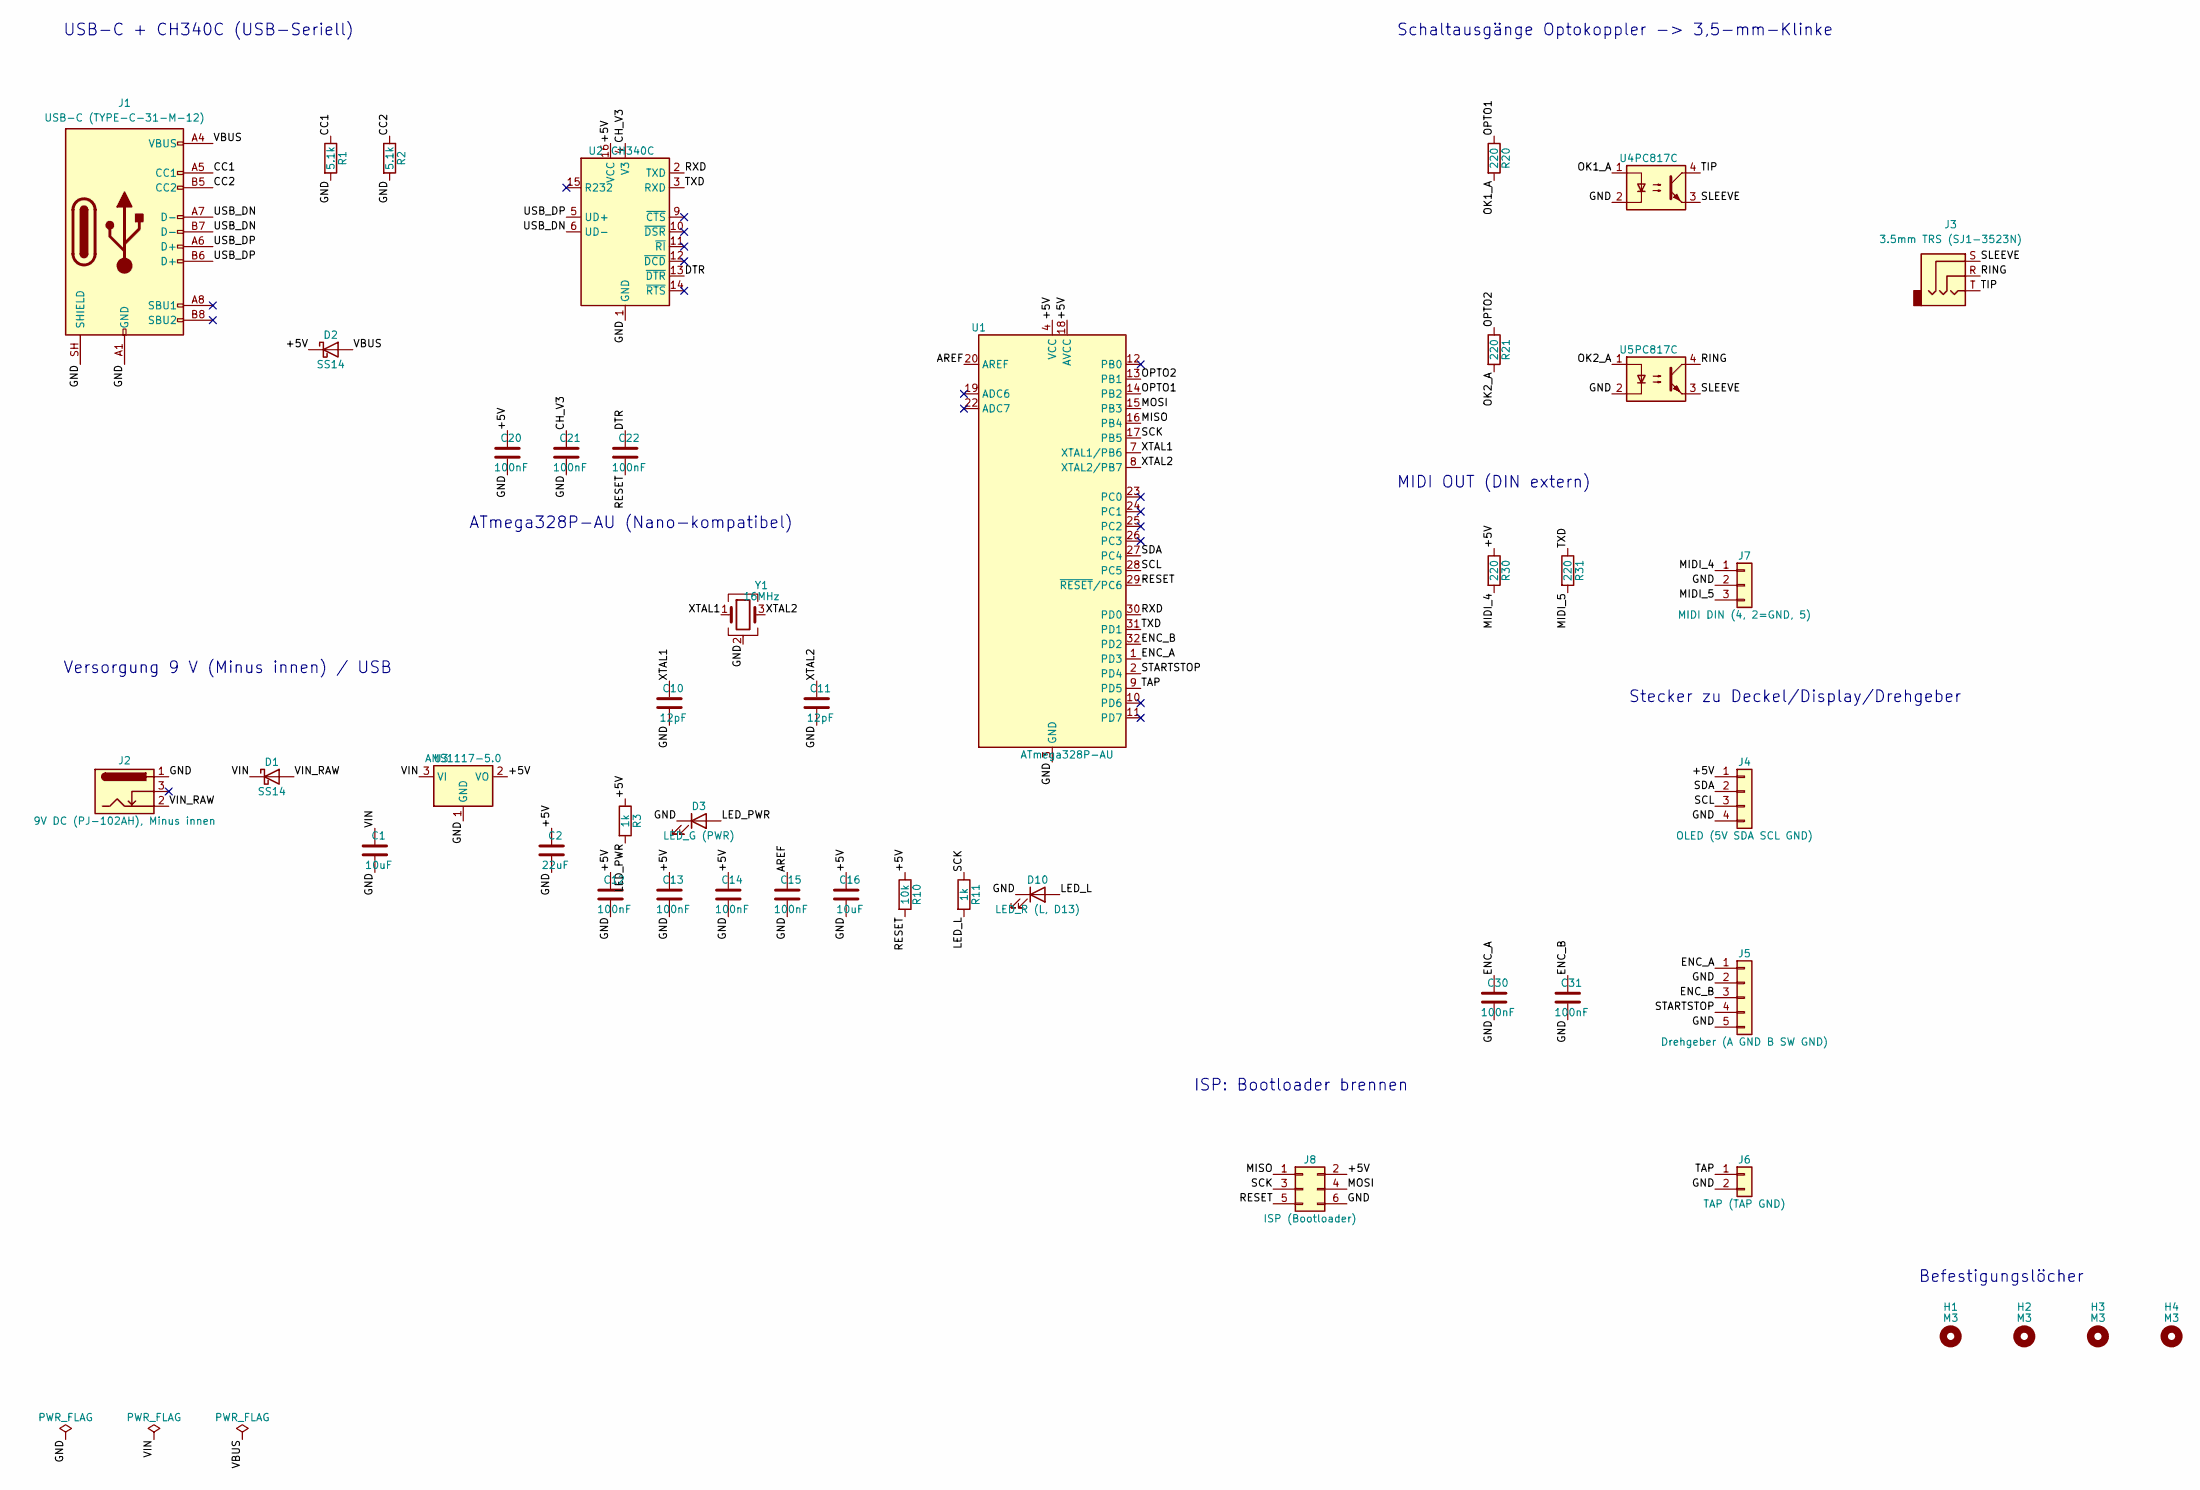
[picture p21: schematic taptempo-smd.kicad_sch, Tap-Tempo / MIDI-Clock Box - SMD (JLCPCB)]

Parts:
C1, C16: 10uF; C_0805_2012Metric; LCSC C15850
C2: 22uF; C_0805_2012Metric; LCSC C45783
C10, C11: 12pF; C_0603_1608Metric; LCSC C38523
C12, C13, C14, C15, C20, C21, C22, C30, C31: 100nF; C_0603_1608Metric; LCSC C14663
D1, D2: SS14; D_SMA; LCSC C2480
D3: LED_G (PWR); LED_0805_2012Metric; LCSC C2297
D10: LED_R (L, D13); LED_0603_1608Metric; LCSC C2286
H1, H2, H3, H4: M3; MountingHole_3.2mm_M3
J1: USB-C (TYPE-C-31-M-12); USB_C_Receptacle_HRO_TYPE-C-31-M-12; LCSC C165948
J2: 9V DC (PJ-102AH), Minus innen; BarrelJack_CUI_PJ-102AH_Horizontal; LCSC C3096093
J3: 3.5mm TRS (SJ1-3523N); Jack_3.5mm_CUI_SJ1-3523N_Horizontal; LCSC C20182914
J4: OLED (5V SDA SCL GND); PinHeader_1x04_P2.54mm_Vertical; LCSC C2691448
J5: Drehgeber (A GND B SW GND); PinHeader_1x05_P2.54mm_Vertical; LCSC C492404
J6: TAP (TAP GND); PinHeader_1x02_P2.54mm_Vertical; LCSC C492401
J7: MIDI DIN (4, 2=GND, 5); PinHeader_1x03_P2.54mm_Vertical; LCSC C2937625
J8: ISP (Bootloader); PinHeader_2x03_P2.54mm_Vertical; LCSC C65114
R1, R2: 5.1k; R_0603_1608Metric; LCSC C23186
R3, R11: 1k; R_0603_1608Metric; LCSC C21190
R10: 10k; R_0603_1608Metric; LCSC C25804
R20, R21, R30, R31: 220; R_0603_1608Metric; LCSC C22962
U1: ATmega328P-AU; TQFP-32_7x7mm_P0.8mm; LCSC C14877
U2: CH340C; SOIC-16_3.9x9.9mm_P1.27mm; LCSC C84681
U3: AMS1117-5.0; SOT-223-3_TabPin2; LCSC C6187
U4, U5: PC817C; SMDIP-4_W9.53mm; LCSC C3025164
Y1: 16MHz; Crystal_SMD_3225-4Pin_3.2x2.5mm; LCSC C13738

Connections:
/+5V: C2.1, C12.1, C13.1, C14.1, C16.1, C20.1, D2.1 (K), J4.1, J8.2, R3.1, R10.1, R30.1, U1.4 (VCC), U1.6 (VCC), U1.18 (AVCC), U2.16 (VCC), U3.2 (VO)
/AREF: C15.1, U1.20 (AREF)
/CC1: J1.A5 (CC1), R1.1
/CC2: J1.B5 (CC2), R2.1
/CH_V3: C21.1, U2.4 (V3)
/DTR: C22.1, U2.13 (~DTR)
/ENC_A: C30.1, J5.1, U1.1 (PD3)
/ENC_B: C31.1, J5.3, U1.32 (PD2)
/GND: C1.2, C2.2, C10.2, C11.2, C12.2, C13.2, C14.2, C15.2, C16.2, C20.2, C21.2, C30.2, C31.2, D3.1 (K), D10.1 (K), J1.A1 (GND), J1.A12 (GND), J1.B1 (GND), J1.B12 (GND), J1.SH (SHIELD), J2.1, J4.4, J5.2, J5.5, J6.2, J7.2, J8.6, R1.2, R2.2, U1.3 (GND), U1.5 (GND), U1.21 (GND), U2.1 (GND), U3.1 (GND), U4.2, U5.2, Y1.2 (G), Y1.4 (G)
/LED_L: D10.2 (A), R11.2
/LED_PWR: D3.2 (A), R3.2
/MIDI_4: J7.1, R30.2
/MIDI_5: J7.3, R31.2
/MISO: J8.1, U1.16 (PB4)
/MOSI: J8.4, U1.15 (PB3)
/OK1_A: R20.2, U4.1
/OK2_A: R21.2, U5.1
/OPTO1: R20.1, U1.14 (PB2)
/OPTO2: R21.1, U1.13 (PB1)
/RESET: C22.2, J8.5, R10.2, U1.29 (~RESET/PC6)
/RING: J3.R, U5.4
/RXD: U1.30 (PD0), U2.2 (TXD)
/SCK: J8.3, R11.1, U1.17 (PB5)
/SCL: J4.3, U1.28 (PC5)
/SDA: J4.2, U1.27 (PC4)
/SLEEVE: J3.S, U4.3, U5.3
/STARTSTOP: J5.4, U1.2 (PD4)
/TAP: J6.1, U1.9 (PD5)
/TIP: J3.T, U4.4
/TXD: R31.1, U1.31 (PD1), U2.3 (RXD)
/USB_DN: J1.A7 (D-), J1.B7 (D-), U2.6 (UD-)
/USB_DP: J1.A6 (D+), J1.B6 (D+), U2.5 (UD+)
/VBUS: D2.2 (A), J1.A4 (VBUS), J1.A9 (VBUS), J1.B4 (VBUS), J1.B9 (VBUS)
/VIN: C1.1, D1.1 (K), U3.3 (VI)
/VIN_RAW: D1.2 (A), J2.2
/XTAL1: C10.1, U1.7 (XTAL1/PB6), Y1.1
/XTAL2: C11.1, U1.8 (XTAL2/PB7), Y1.3

Notes on the sheet:
USB-C + CH340C (USB-Seriell)
Versorgung 9 V (Minus innen) / USB
ATmega328P-AU (Nano-kompatibel)
Schaltausgänge Optokoppler -> 3,5-mm-Klinke
MIDI OUT (DIN extern)
Stecker zu Deckel/Display/Drehgeber
ISP: Bootloader brennen
Befestigungslöcher

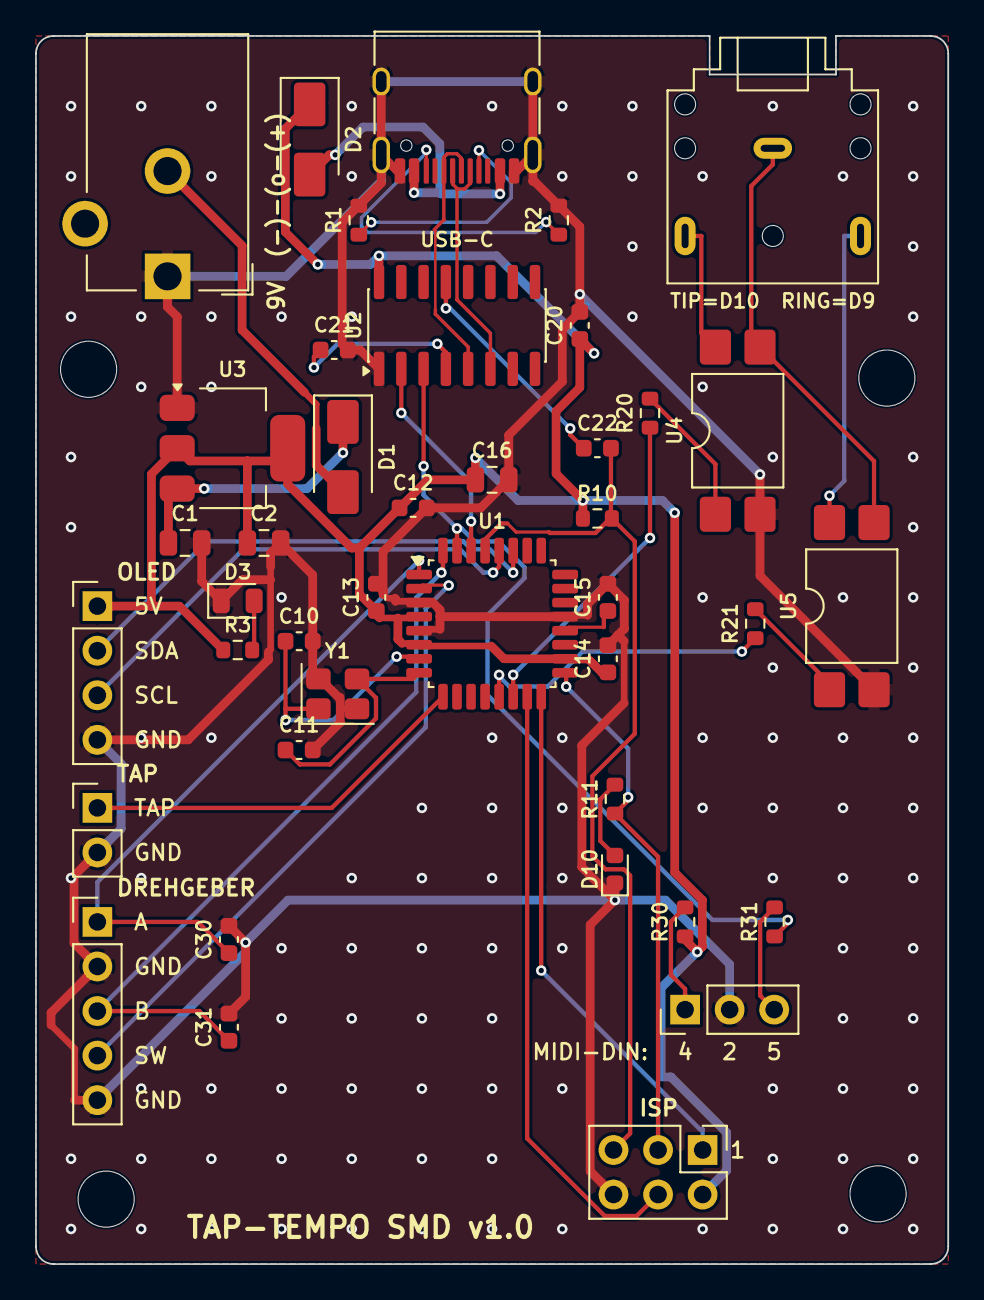
[picture p22: board taptempo-smd.kicad_pcb from above]

Board: 2 copper layers, 52.0 x 70.0 mm, 45 parts (0 on the bottom side), 37 nets.
