Valleeh/taptempo-box/nano-perfboard/kicad/taptempo.kicad_sch

## KiCad design nano-perfboard/kicad/taptempo.kicad_sch (2026-10-27)

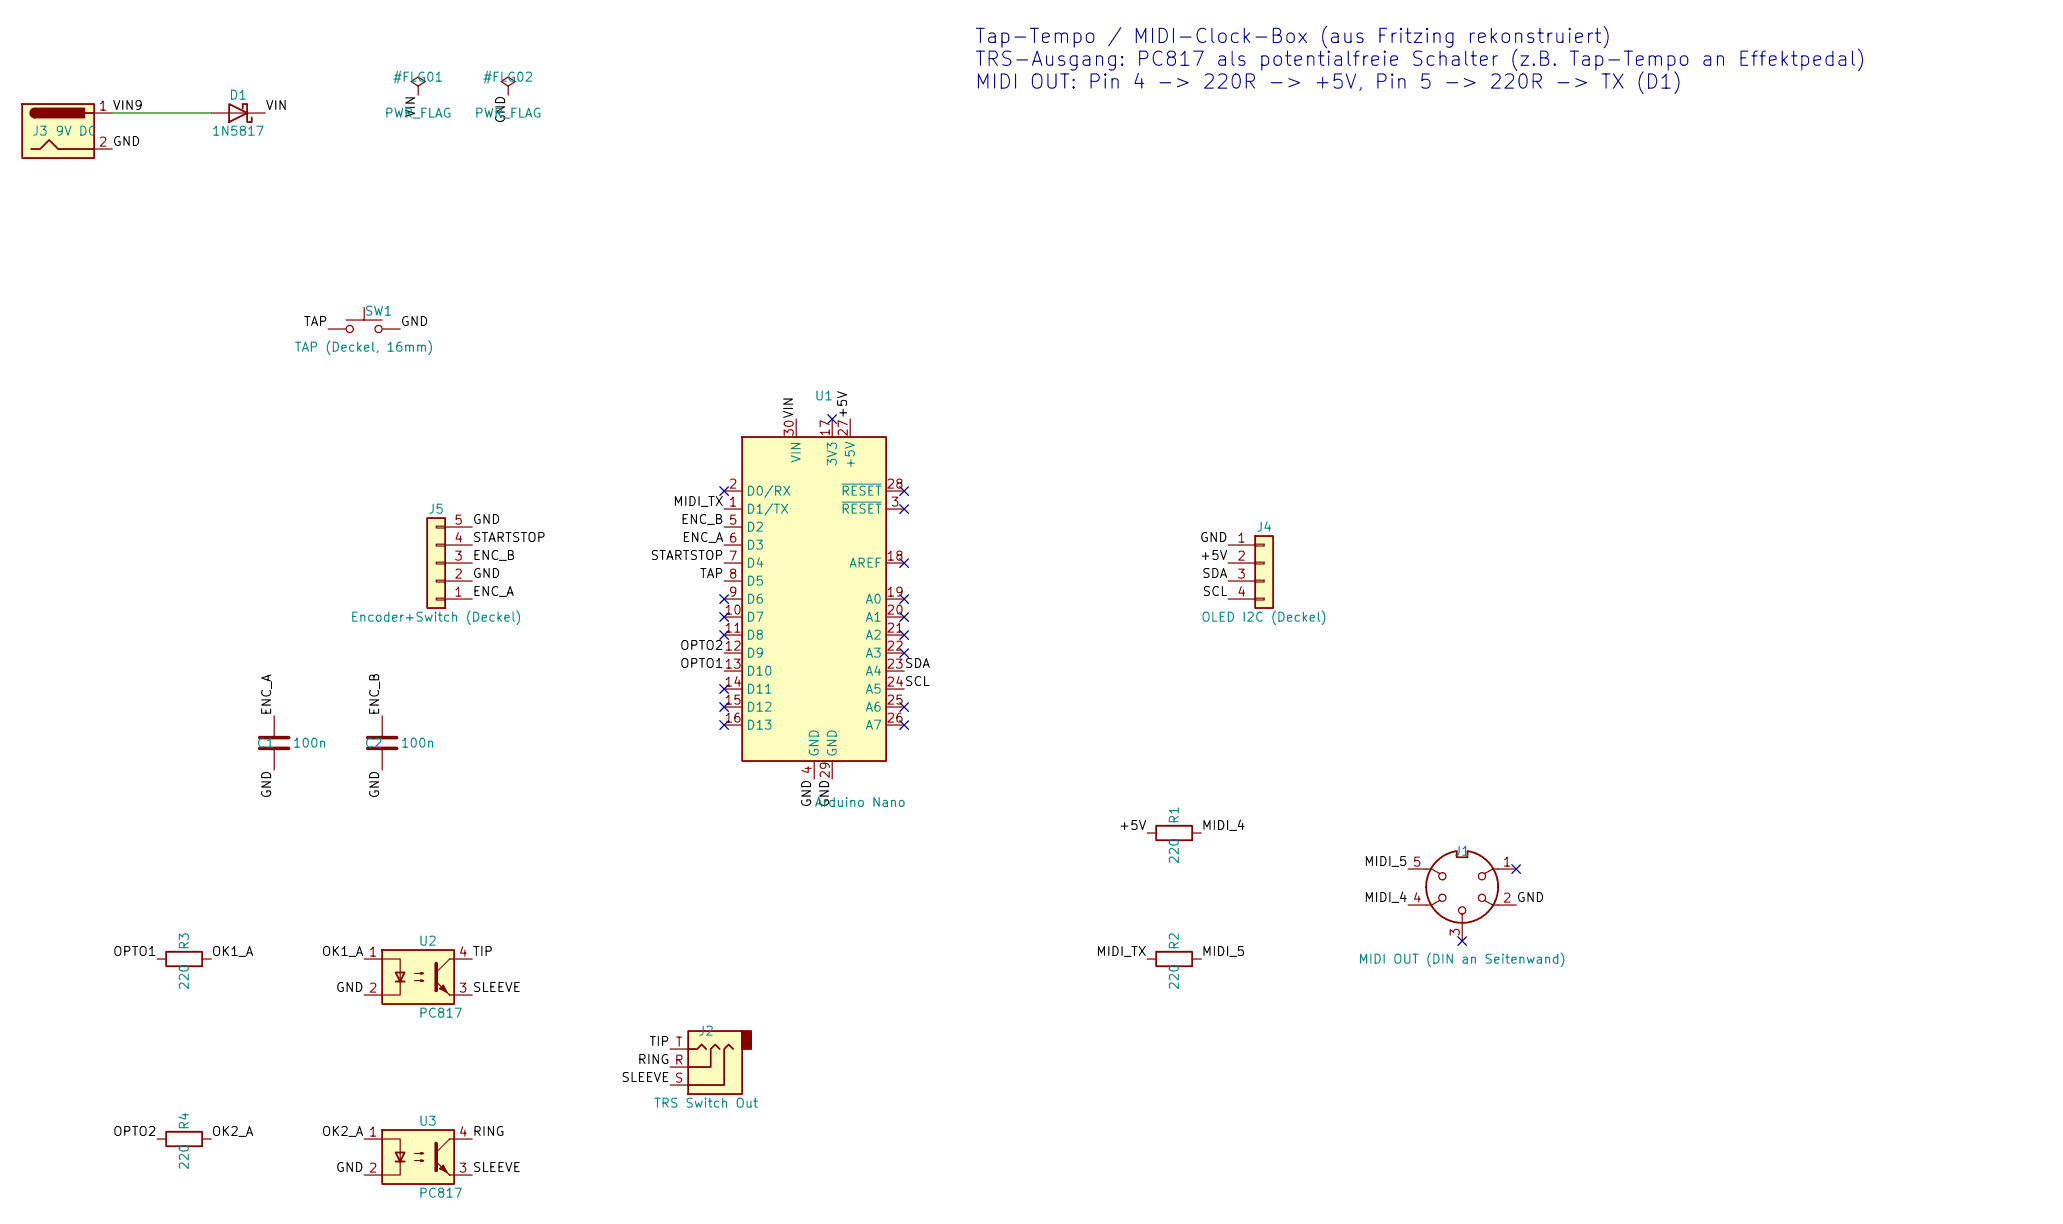
[picture p23: schematic taptempo.kicad_sch]

Parts:
C1, C2: 100n; C_Disc_D3.0mm_W1.6mm_P2.50mm
D1: 1N5817; D_DO-41_SOD81_P10.16mm_Horizontal
J1: MIDI OUT (DIN an Seitenwand); PinHeader_1x05_P2.54mm_Vertical
J2: TRS Switch Out; Jack_3.5mm_CUI_SJ1-3513N_Horizontal
J3: 9V DC; BarrelJack_Horizontal
J4: OLED I2C (Deckel); PinHeader_1x04_P2.54mm_Vertical
J5: Encoder+Switch (Deckel); PinHeader_1x05_P2.54mm_Vertical
R1, R2, R3, R4: 220; R_Axial_DIN0207_L6.3mm_D2.5mm_P10.16mm_Horizontal
SW1: TAP (Deckel, 16mm); PinHeader_1x02_P2.54mm_Vertical
U1: Arduino Nano; Arduino_Nano
U2, U3: PC817; DIP-4_W7.62mm

Connections:
+5V: J4.2, R1.1, U1.27 (+5V)
ENC_A: C1.1, J5.1, U1.6 (D3)
ENC_B: C2.1, J5.3, U1.5 (D2)
GND: C1.2, C2.2, J1.2, J3.2, J4.1, J5.2, J5.5, SW1.2, U1.4 (GND), U1.29 (GND), U2.2, U3.2
MIDI_4: J1.4, R1.2
MIDI_5: J1.5, R2.2
MIDI_TX: R2.1, U1.1 (D1/TX)
OK1_A: R3.2, U2.1
OK2_A: R4.2, U3.1
OPTO1: R3.1, U1.13 (D10)
OPTO2: R4.1, U1.12 (D9)
RING: J2.R, U3.4
SCL: J4.4, U1.24 (A5)
SDA: J4.3, U1.23 (A4)
SLEEVE: J2.S, U2.3, U3.3
STARTSTOP: J5.4, U1.7 (D4)
TAP: SW1.1, U1.8 (D5)
TIP: J2.T, U2.4
VIN: D1.1 (K), U1.30 (VIN)
VIN9: D1.2 (A), J3.1

Notes on the sheet:
Tap-Tempo / MIDI-Clock-Box (aus Fritzing rekonstruiert) TRS-Ausgang: PC817 als potentialfreie Schalter (z.B. Tap-Tempo an Effektpedal) MIDI OUT: Pin 4 -> 220R -> +5V, Pin 5 -> 220R -> TX (D1)
